MaichlHendi/PARTICLE-ACCELERATOR/README.md

# PARTICLE-ACCELERATOR

A particle accelerator prototype built to propel a metal ball along a track, powered by a supercapacitor with a runtime of at least 10 seconds.

Unfortunately, the circuit schematic is not available.
